kitekid250/The-Vulture/Mechanical/Other/WingPotMount_Rendering.JPG

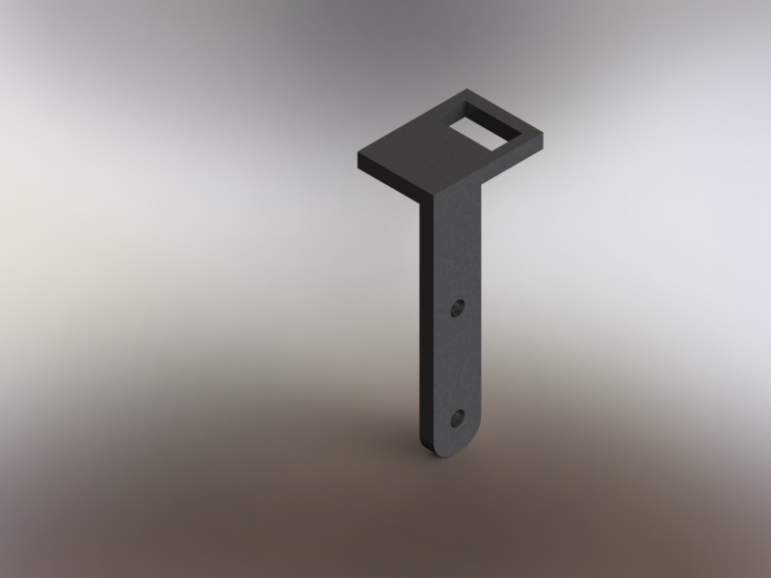
Mechanical/Other/WingPotMount_Rendering.JPG
