kitekid250/The-Vulture/README.md

# The-Vulture
Work done on the robotic Vulture for Dana 147
