kitekid250/The-Vulture/Mechanical/03.gif

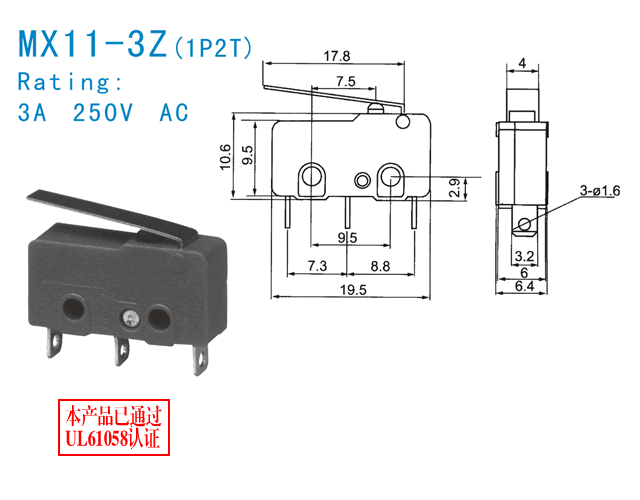
Mechanical/03.gif
