kitekid250/The-Vulture/Mechanical/Tensioner Sub Assembly/TensionerAssembly.SLDASM

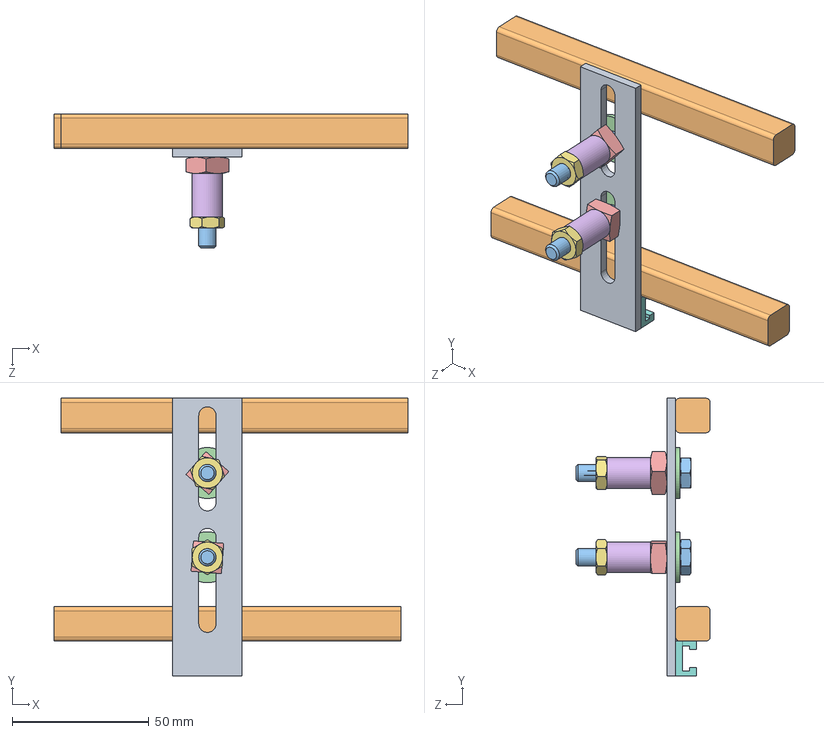
[picture p3: CAD file, 2015-04-28]
Mechanical/Tensioner Sub Assembly/TensionerAssembly.SLDASM
129.5 x 101.6 x 49.2 mm
Back plate
Bar x 2
hex finished bolt_ai x 2
flat washer type b regular_ai x 2
square nut_61_ai x 2
Roller x 2
hex jam nut_ai x 2
Sensor Mount
