kitekid250/The-Vulture/Mechanical/Other/ArmsPotentiometerSupport_Revised.STL

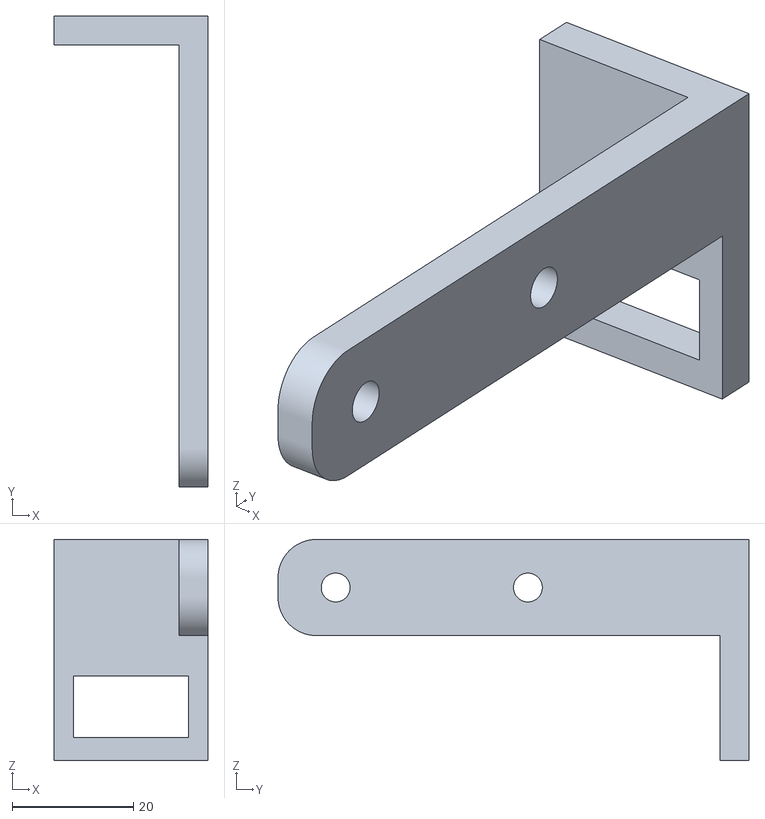
[picture p4: CAD file, 2015-04-28]
Mechanical/Other/ArmsPotentiometerSupport_Revised.STL
25.4 x 77.8 x 36.5
