kitekid250/The-Vulture/Mechanical/Parts/Front Panel.SLDPRT

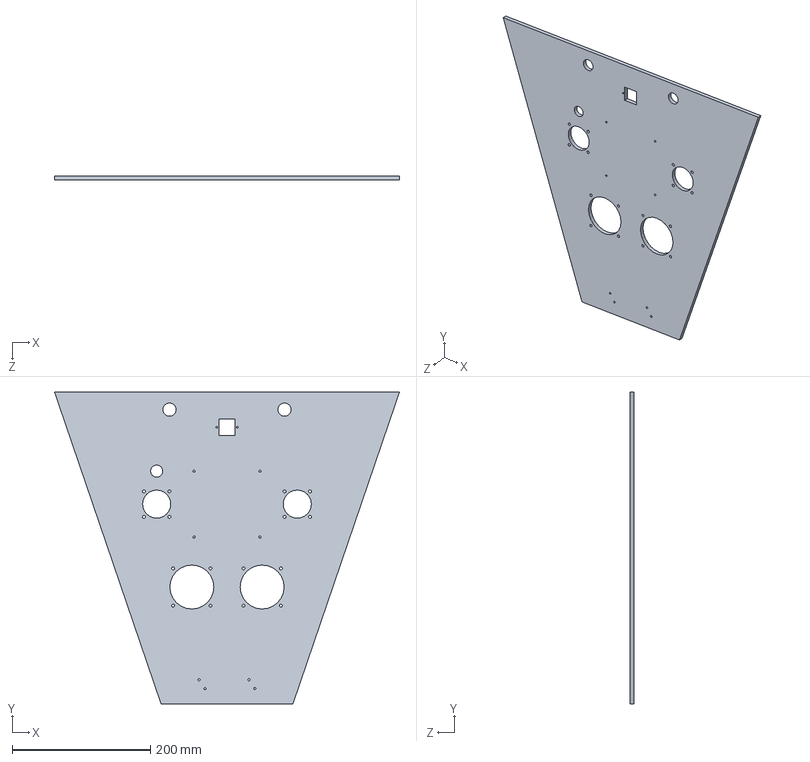
[picture p5: CAD file, 2015-05-24]
Mechanical/Parts/Front Panel.SLDPRT
498.5 x 450.7 x 6.35 mm
