kitekid250/The-Vulture/Mechanical/Tensioner Sub Assembly/Sensor Mount.SLDPRT

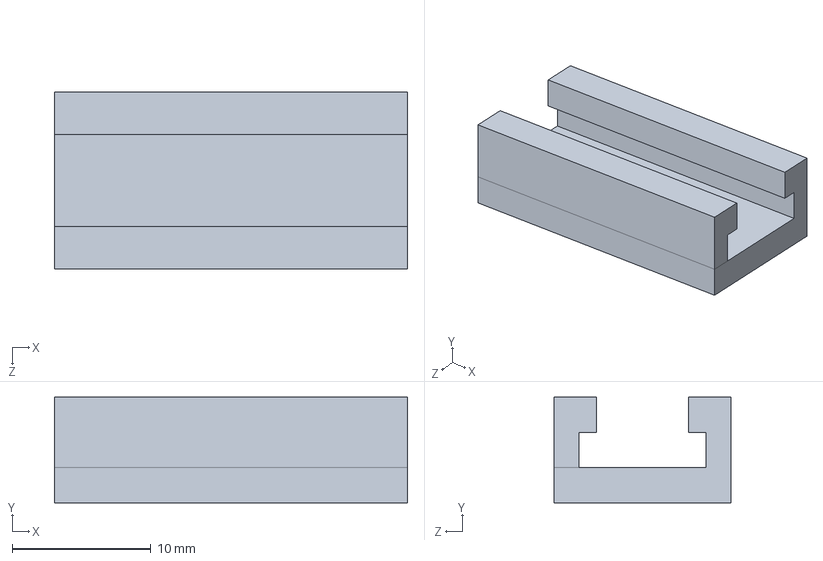
[picture p6: CAD file, 2015-04-28]
Mechanical/Tensioner Sub Assembly/Sensor Mount.SLDPRT
25.4 x 7.62 x 12.7 mm
