kitekid250/The-Vulture/Mechanical/Other/Electronics Plate.DXF

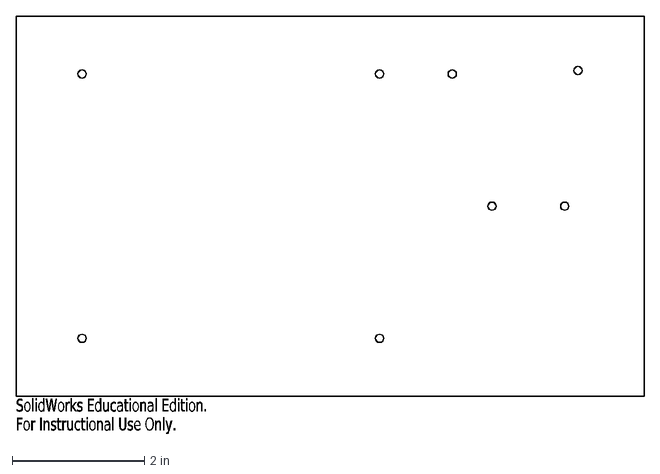
[picture p7: CAD file, 2015-04-28]
Mechanical/Other/Electronics Plate.DXF
SolidWorks Educational Edition.
For Instructional Use Only.
