kitekid250/The-Vulture/Mechanical/Parts/Triangle.SLDPRT

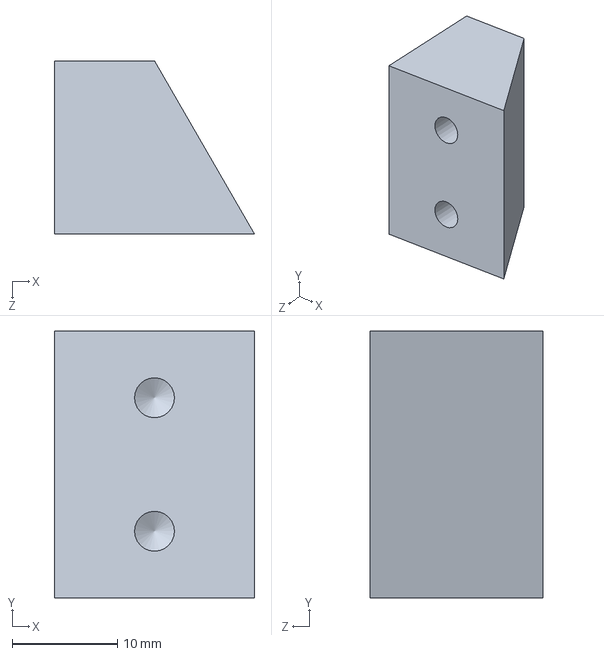
[picture p8: CAD file, 2015-05-15]
Mechanical/Parts/Triangle.SLDPRT
19.1 x 25.4 x 16.5 mm
