kitekid250/The-Vulture/Mechanical/Tensioner Sub Assembly/Bar.SLDPRT

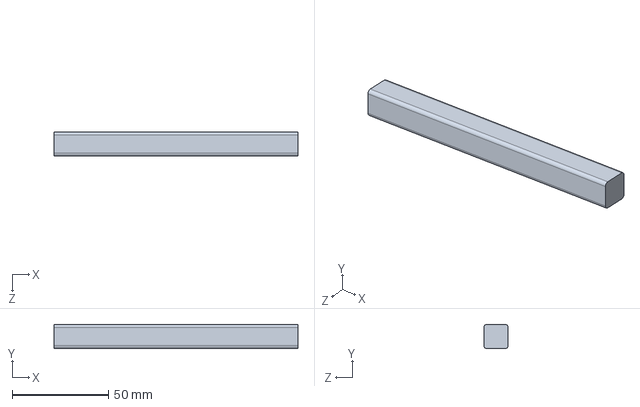
[picture p9: CAD file, 2015-04-28]
Mechanical/Tensioner Sub Assembly/Bar.SLDPRT
127.0 x 12.7 x 12.7 mm
