kitekid250/The-Vulture/Mechanical/Parts/Wing Top Limit Switch Mount.SLDPRT

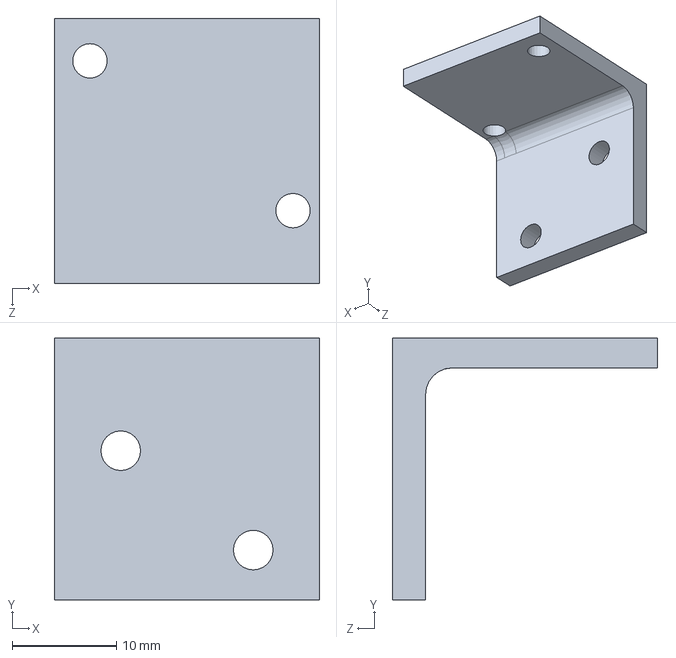
[picture p10: CAD file, 2015-05-15]
Mechanical/Parts/Wing Top Limit Switch Mount.SLDPRT
25.4 x 25.1 x 25.4 mm
