kitekid250/The-Vulture/Mechanical/Parts/LPOTPT.SLDPRT

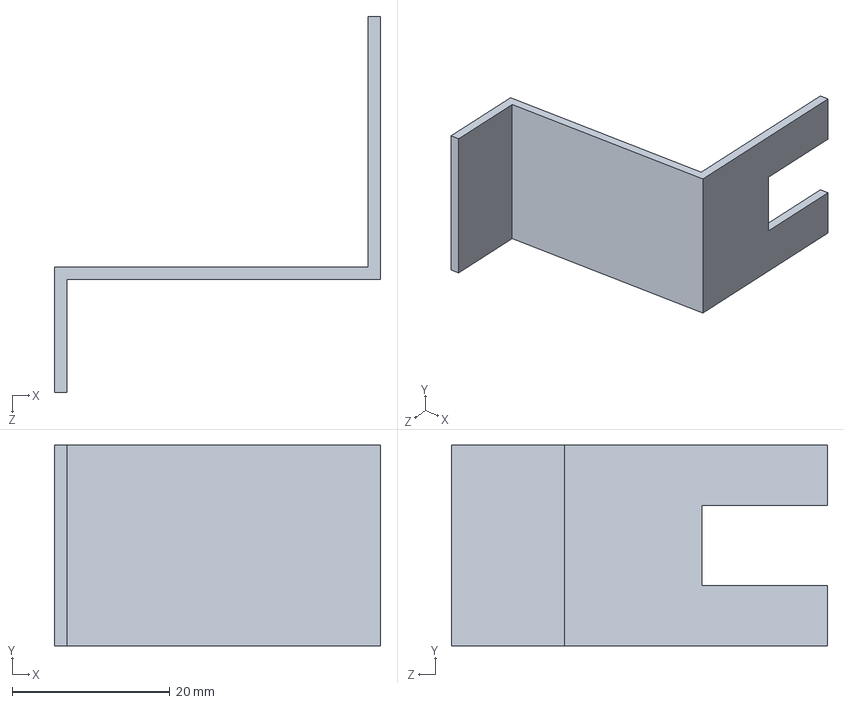
[picture p11: CAD file, 2015-04-28]
Mechanical/Parts/LPOTPT.SLDPRT
41.3 x 25.4 x 47.6 mm
