kitekid250/The-Vulture/Mechanical/Tensioner Sub Assembly/Roller.SLDPRT

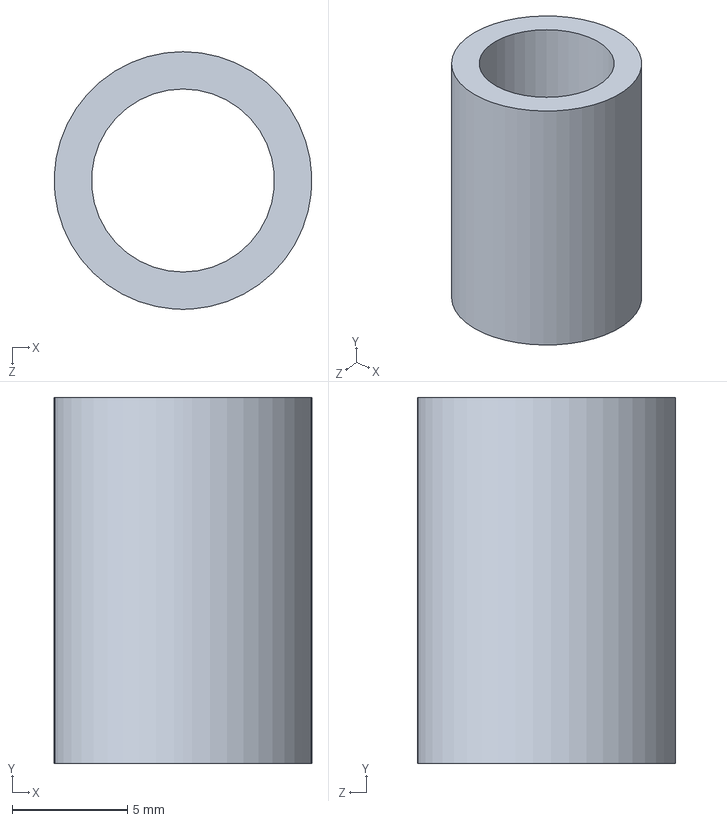
[picture p12: CAD file, 2015-04-28]
Mechanical/Tensioner Sub Assembly/Roller.SLDPRT
11.2 x 15.9 x 11.2 mm
