kitekid250/The-Vulture/Mechanical/Tensioner Sub Assembly/Back plate.SLDPRT

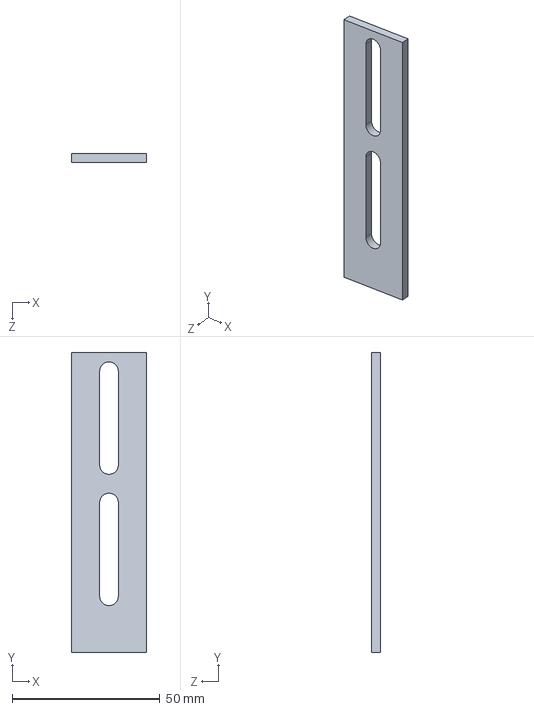
[picture p13: CAD file, 2015-04-28]
Mechanical/Tensioner Sub Assembly/Back plate.SLDPRT
25.4 x 101.6 x 3.17 mm
