kitekid250/The-Vulture/Mechanical/Parts/RPOTPT.SLDPRT

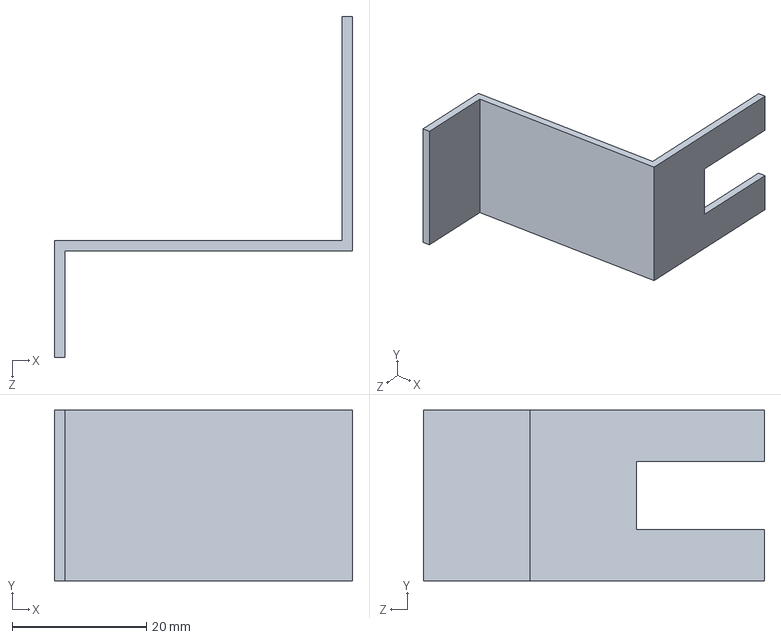
[picture p14: CAD file, 2015-04-28]
Mechanical/Parts/RPOTPT.SLDPRT
44.5 x 25.4 x 50.8 mm
