kitekid250/The-Vulture/Mechanical/Parts/NeckLimitswitchMountBottom.SLDPRT

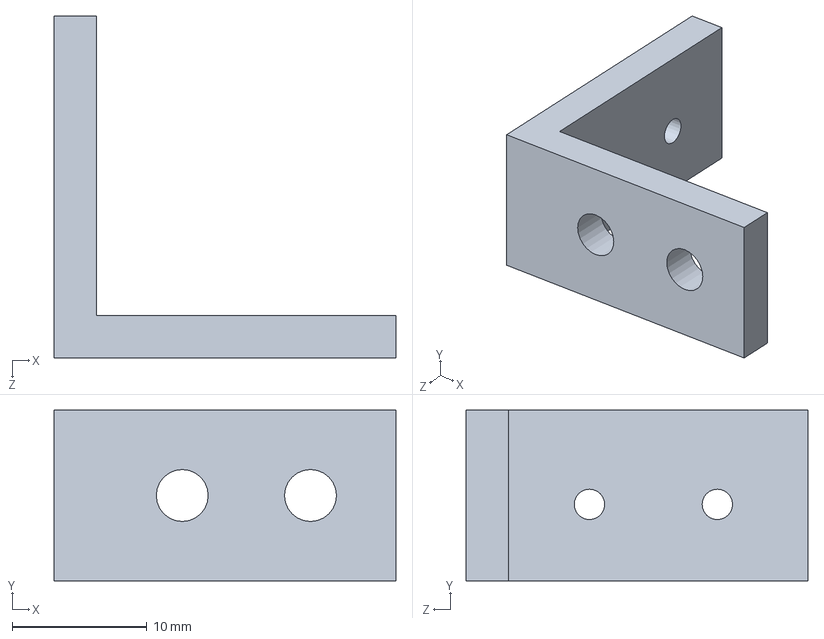
[picture p15: CAD file, 2015-04-28]
Mechanical/Parts/NeckLimitswitchMountBottom.SLDPRT
25.4 x 12.7 x 25.4 mm
