kitekid250/The-Vulture/Mechanical/Parts/Shoulder Top Limit Switch Mount V2.SLDPRT

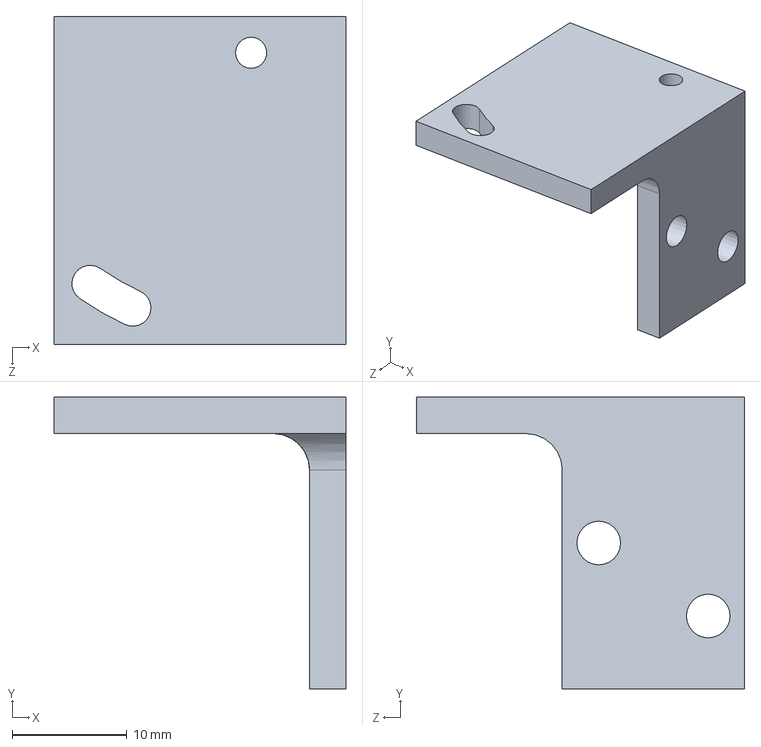
[picture p16: CAD file, 2015-04-28]
Mechanical/Parts/Shoulder Top Limit Switch Mount V2.SLDPRT
25.4 x 25.4 x 28.6 mm
