kitekid250/The-Vulture/Mechanical/Parts/Wing Pot Support V2.SLDPRT

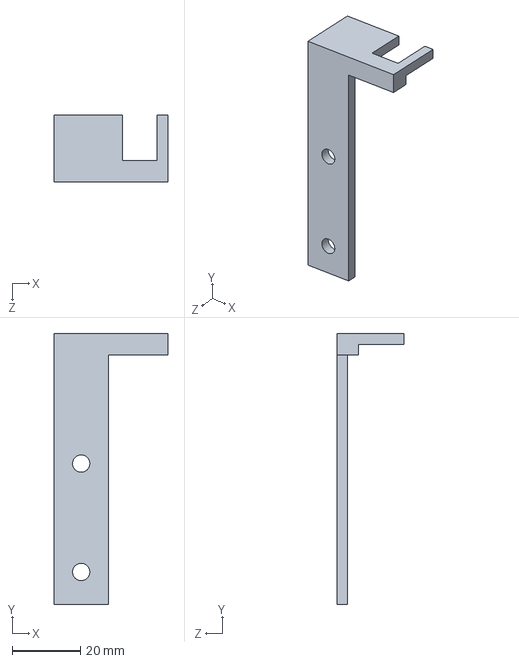
[picture p17: CAD file, 2015-04-28]
Mechanical/Parts/Wing Pot Support V2.SLDPRT
33.3 x 79.4 x 19.7 mm
