kitekid250/The-Vulture/Mechanical/Parts/NeckLimitswitchMountTop.SLDPRT

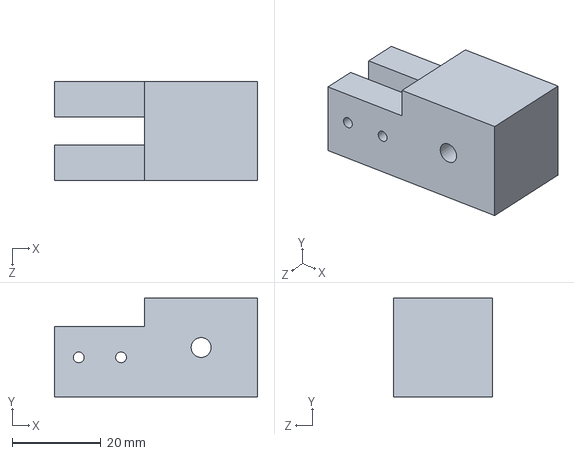
[picture p18: CAD file, 2015-04-28]
Mechanical/Parts/NeckLimitswitchMountTop.SLDPRT
45.7 x 22.2 x 22.2 mm
