kitekid250/The-Vulture/Mechanical/Parts/WingPotentiometerSupport_Revised.SLDPRT

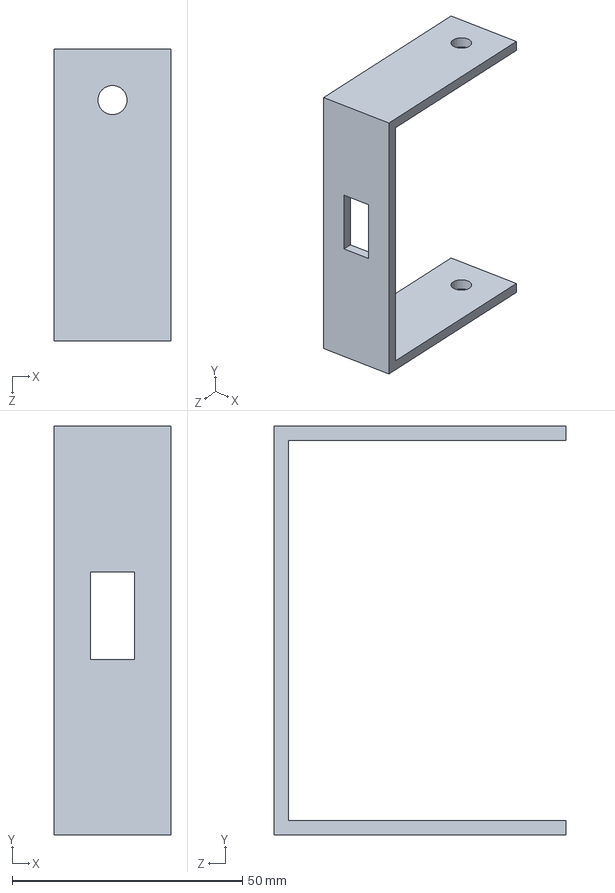
[picture p19: CAD file, 2015-04-28]
Mechanical/Parts/WingPotentiometerSupport_Revised.SLDPRT
25.4 x 88.9 x 63.5 mm
