kitekid250/The-Vulture/Mechanical/Parts/Speaker Offset.SLDPRT

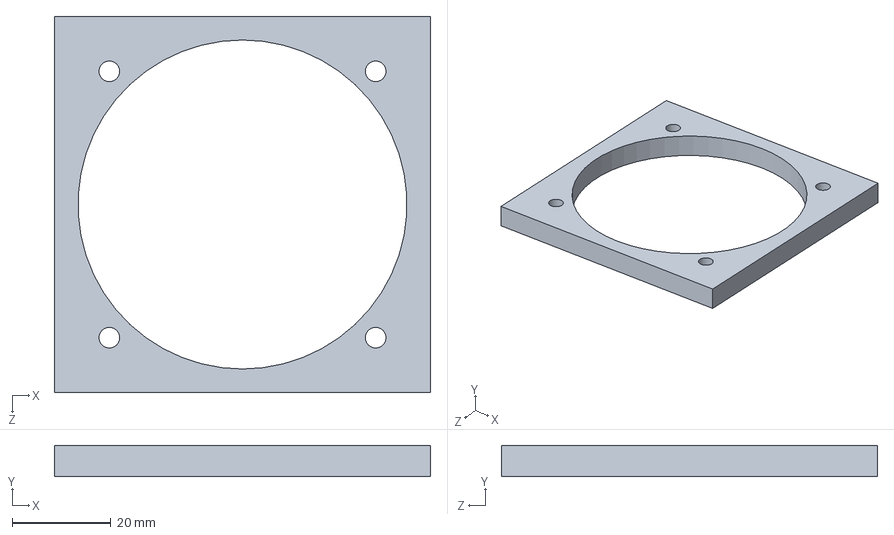
[picture p20: CAD file, 2015-04-28]
Mechanical/Parts/Speaker Offset.SLDPRT
76.2 x 6.35 x 76.2 mm
