kitekid250/The-Vulture/Mechanical/Parts/Fix.SLDPRT

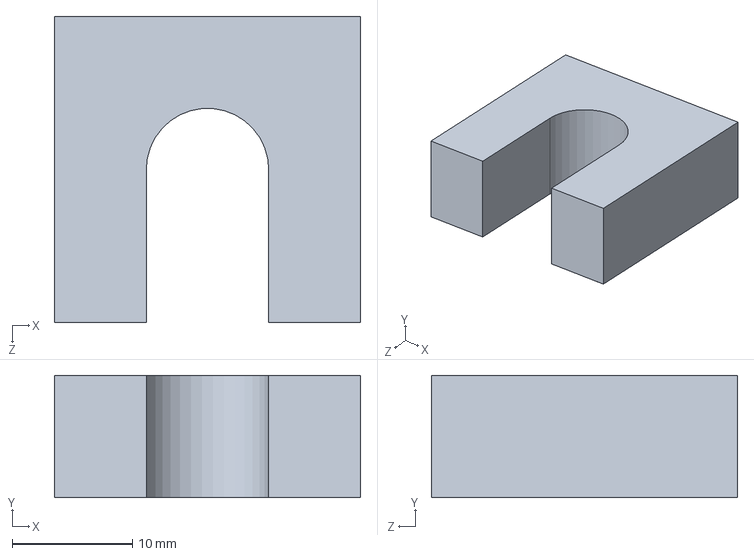
[picture p21: CAD file, 2015-04-28]
Mechanical/Parts/Fix.SLDPRT
25.4 x 10.2 x 25.4 mm
