kitekid250/The-Vulture/Mechanical/Parts/Neck Carriage.SLDPRT

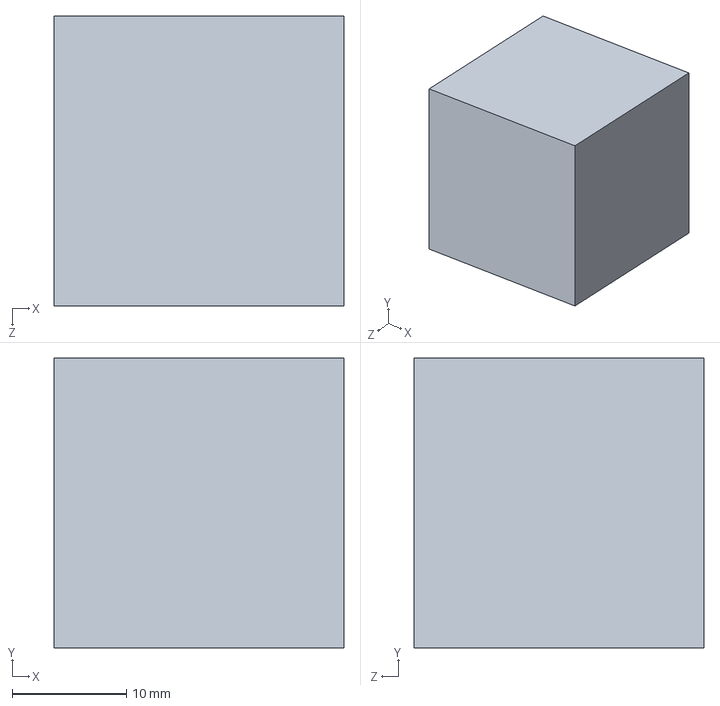
[picture p22: CAD file, 2015-04-28]
Mechanical/Parts/Neck Carriage.SLDPRT
25.4 x 25.4 x 25.4 mm
