kitekid250/The-Vulture/Mechanical/Parts/PlexiBottomHook V1.SLDPRT

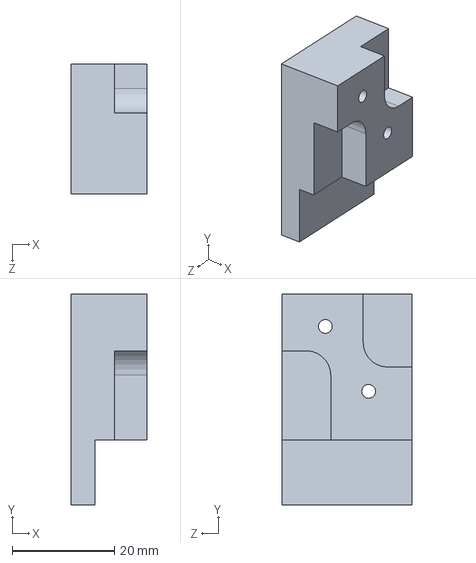
[picture p23: CAD file, 2015-04-28]
Mechanical/Parts/PlexiBottomHook V1.SLDPRT
14.9 x 41.3 x 25.4 mm
