kitekid250/The-Vulture/Mechanical/Parts/Wing Pot Holder V2.SLDPRT

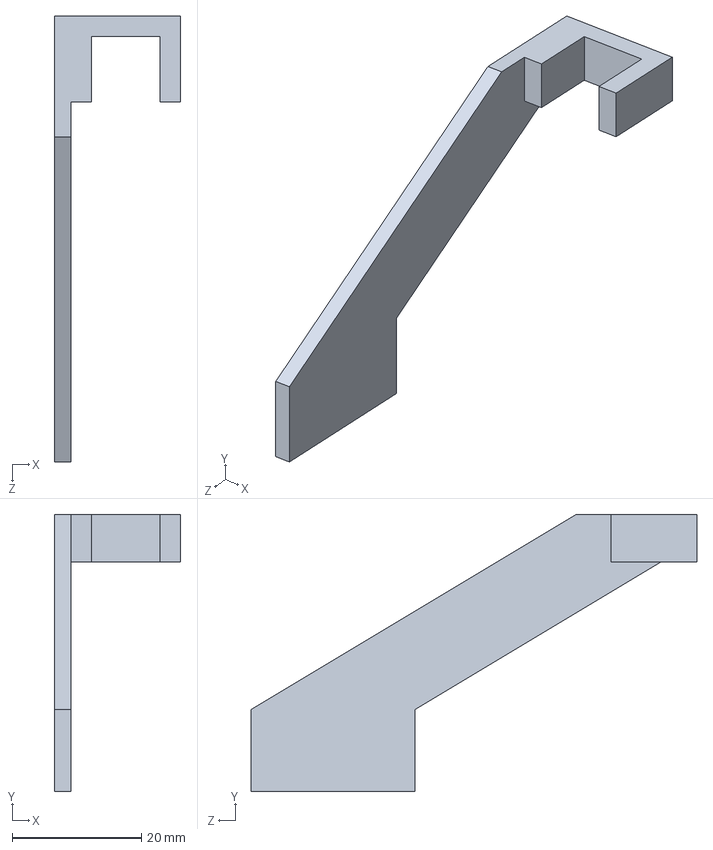
[picture p24: CAD file, 2015-04-28]
Mechanical/Parts/Wing Pot Holder V2.SLDPRT
19.6 x 42.9 x 69.1 mm
