kitekid250/The-Vulture/Mechanical/Parts/Electronics Plate.SLDPRT

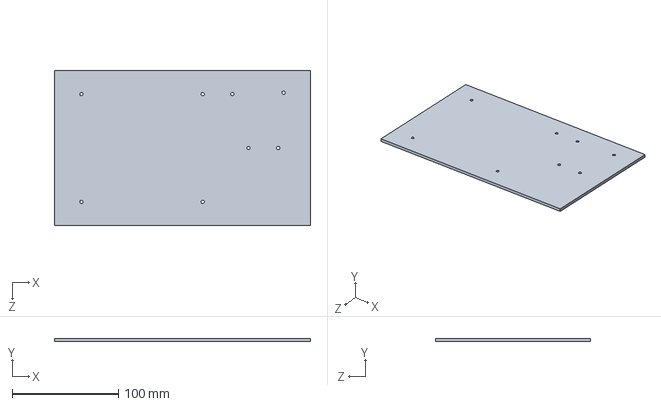
[picture p25: CAD file, 2015-04-28]
Mechanical/Parts/Electronics Plate.SLDPRT
241.3 x 3.17 x 146.1 mm
