kitekid250/The-Vulture/Mechanical/Parts/Wing LS Outside Actuator.SLDPRT

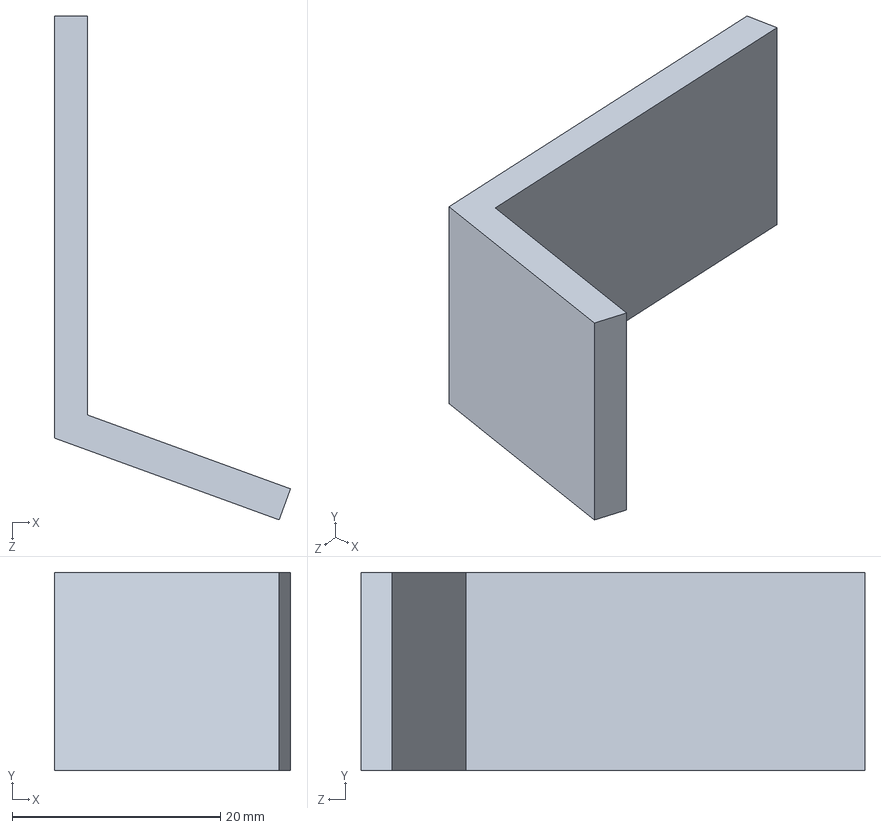
[picture p26: CAD file, 2015-04-28]
Mechanical/Parts/Wing LS Outside Actuator.SLDPRT
22.7 x 19.1 x 48.4 mm
