kitekid250/The-Vulture/Mechanical/Parts/Wing LS Inside.SLDPRT

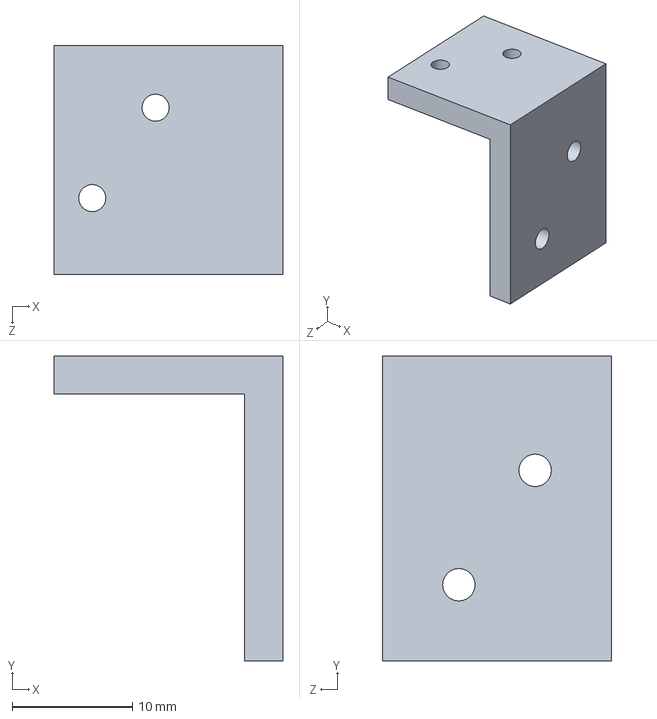
[picture p27: CAD file, 2015-04-28]
Mechanical/Parts/Wing LS Inside.SLDPRT
19.1 x 25.4 x 19.0 mm
