kitekid250/The-Vulture/(list of files, cad)

Other CAD files:
Mechanical/Parts/ArmsPotentiometerSupport_Revised.SLDPRT
Mechanical/Parts/TPOTPT.SLDPRT
Mechanical/Drawings/Front Panel.SLDDRW
Mechanical/Drawings/LPOTPT.SLDDRW
Mechanical/Drawings/NeckLimitswitchMountBottom.SLDDRW
Mechanical/Drawings/NeckTopLimitSwitchMount.SLDDRW
Mechanical/Drawings/PlexiBottomHook V1.SLDDRW
Mechanical/Drawings/PlexiBottomHook V2.SLDDRW
Mechanical/Drawings/RPOTPT.SLDDRW
Mechanical/Drawings/TPOTPT.SLDDRW
Mechanical/Drawings/Vulture Parts to Fab.SLDDRW
Mechanical/Drawings/Wing LS Inside.SLDDRW
Mechanical/Drawings/WingTipLimitSwitchMount.SLDDRW
Mechanical/Parts/Shoulder Top Limit Switch Mount V2.SLDDRW
Mechanical/Tensioner Sub Assembly/TensionerParts.SLDDRW
