kitekid250/The-Vulture/Mechanical/Tensioner Sub Assembly/TensionerPartsFinal.PDF

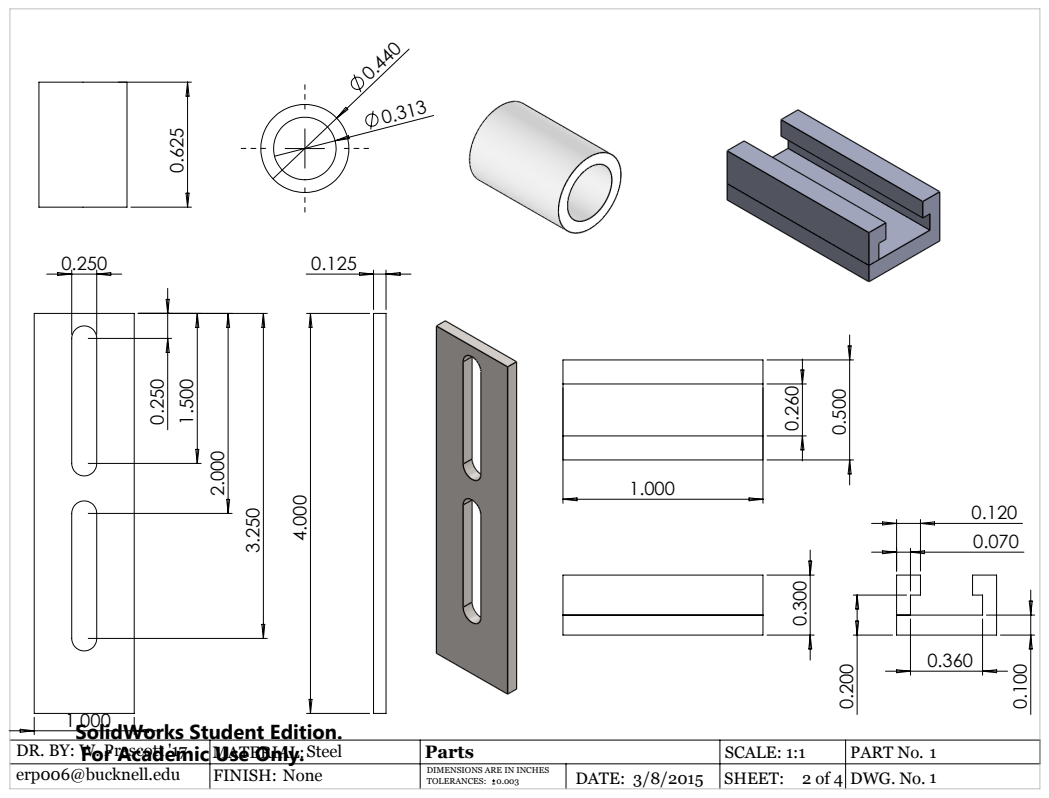
[picture p29: page 1]

SolidWorks Student Edition.

For Academic Use Only. DR. BY: W. Prescott '17 | MATERIAL: Steel | Parts | SCALE: 1:1 | 1 PART No.
erp006@bucknell.edu | FINISH: None | TOLERANCES: 0.003 | 3/8/2015 DATE: | 2 of 4 DIMENSIONS ARE IN INCHES SHEET: | 1 DWG. No.
