kitekid250/The-Vulture/Mechanical/Drawings/Front Panel.PDF

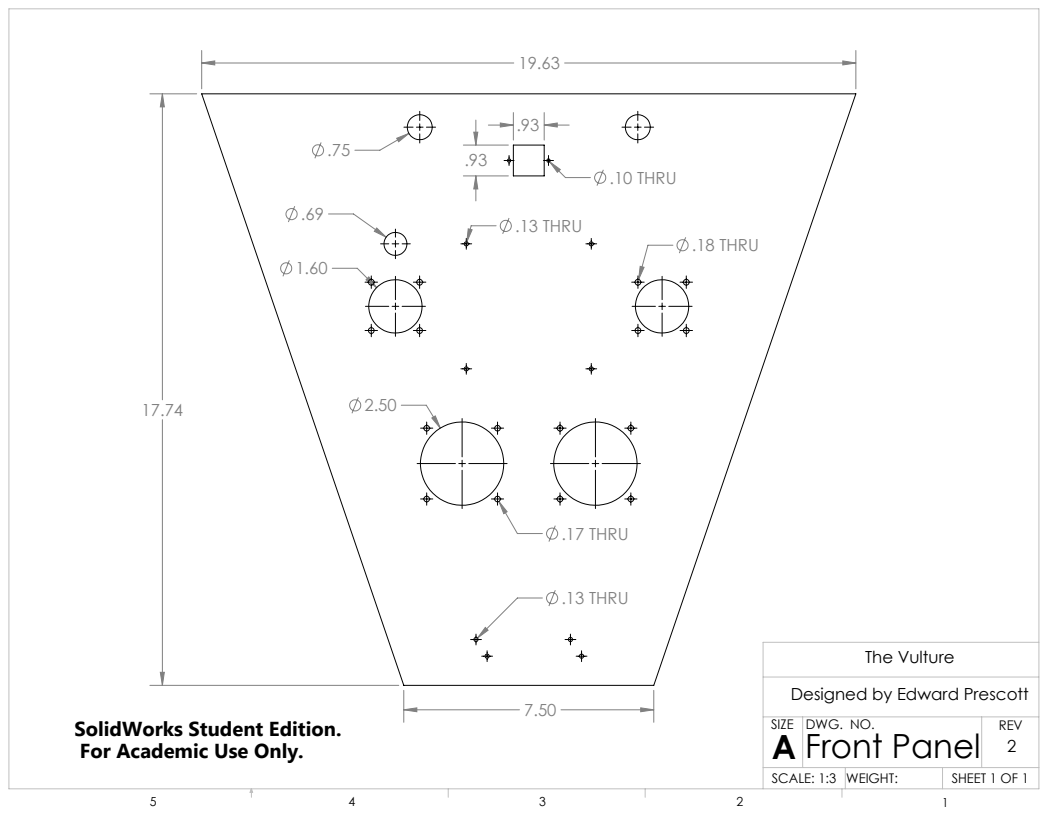
[picture p30: page 1]
.13 THRU; .18 THRU; .10 THRU; .17 THRU; The Vulture; Front Panel 2; SCALE: 1:3 WEIGHT:; SHEET 1 OF 1; DWG. NO.; REV

Designed by Edward Prescott
SIZE

SolidWorks Student Edition.
For Academic Use Only.
