kitekid250/The-Vulture/Circuit/Vulture Controls - Copy.brd

## EAGLE design Circuit/Vulture Controls - Copy.brd (2015-09-29, an earlier design)

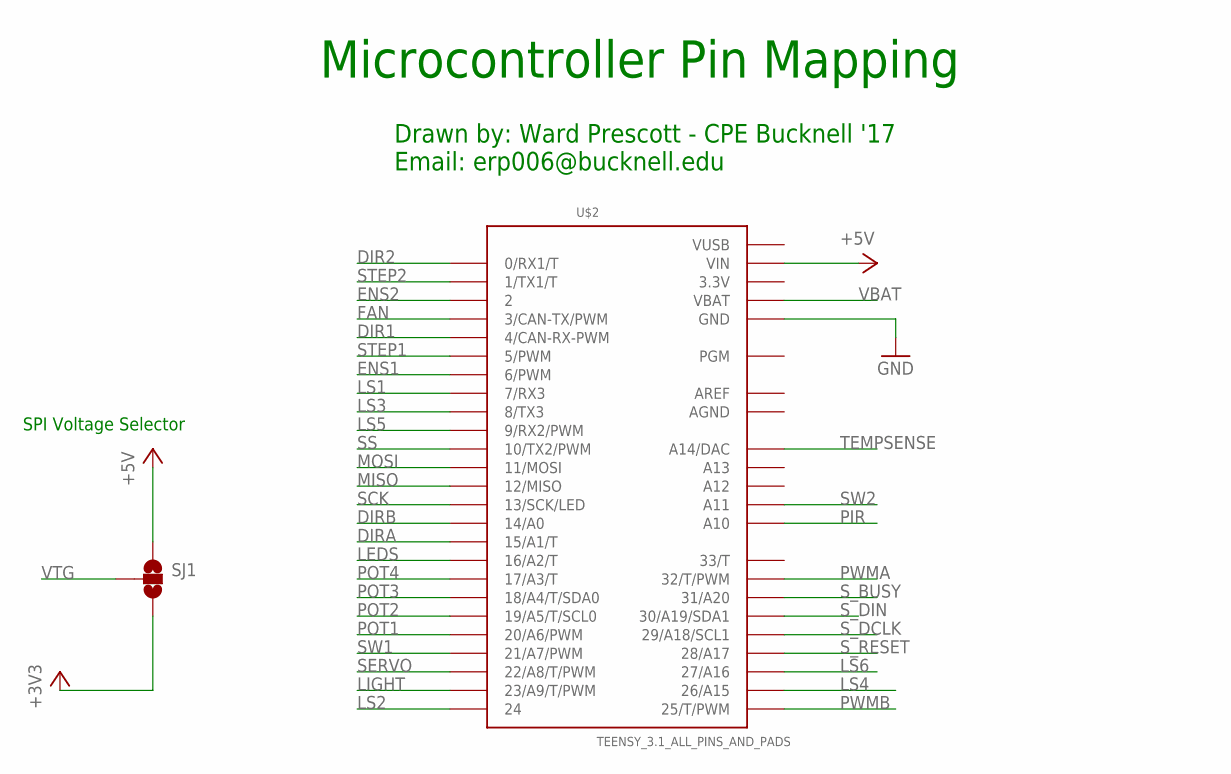
[picture p31: schematic Vulture Controls - Copy.sch, sheet 1, IC - Teensy 3.1]

Parts:
SJ1: JUMPER-PAD-3-NOFULL_BOX_SILK; PAD-JUMPER-3-NO_YES_SILK_FULL_BOX
U$2: TEENSY_3.1_ALL_PINS_AND_PADS; TEENSY_3.1_ALLPINS

Connections:
3.3V: U$2.3.3V, U$2.3.3V1 (3.3V), U$2.3.3V2 (3.3V)
+3V3: SJ1.3; also elsewhere on the board
+5V: SJ1.1, U$2.VIN; also elsewhere on the board
AGND: U$2.AGND
AREF: U$2.AREF
DIR1: U$2.4 (4/CAN-RX-PWM); also elsewhere on the board
DIR2: U$2.0 (0/RX1/T); also elsewhere on the board
DIRA: U$2.15/A1 (15/A1/T); also elsewhere on the board
DIRB: U$2.14/A0; also elsewhere on the board
ENS1: U$2.6 (6/PWM); also elsewhere on the board
ENS2: U$2.2; also elsewhere on the board
FAN: U$2.3 (3/CAN-TX/PWM); also elsewhere on the board
GND: U$2.GND, U$2.GND1 (GND), U$2.GND2 (GND); also elsewhere on the board
LEDS: U$2.16/A2 (16/A2/T); also elsewhere on the board
LIGHT: U$2.23/A9 (23/A9/T/PWM); also elsewhere on the board
LS1: U$2.7 (7/RX3); also elsewhere on the board
LS2: U$2.24; also elsewhere on the board
LS3: U$2.8 (8/TX3); also elsewhere on the board
LS4: U$2.26 (26/A15); also elsewhere on the board
LS5: U$2.9 (9/RX2/PWM); also elsewhere on the board
LS6: U$2.27 (27/A16); also elsewhere on the board
MISO: U$2.12 (12/MISO); also elsewhere on the board
MOSI: U$2.11 (11/MOSI); also elsewhere on the board
PIR: U$2.A10; also elsewhere on the board
POT1: U$2.20/A6 (20/A6/PWM); also elsewhere on the board
POT2: U$2.19/A5 (19/A5/T/SCL0); also elsewhere on the board
POT3: U$2.18/A4 (18/A4/T/SDA0); also elsewhere on the board
POT4: U$2.17/A3 (17/A3/T); also elsewhere on the board
PWMA: U$2.32 (32/T/PWM); also elsewhere on the board
PWMB: U$2.25 (25/T/PWM); also elsewhere on the board
SCK: U$2.13 (13/SCK/LED); also elsewhere on the board
SERVO: U$2.22/A8 (22/A8/T/PWM); also elsewhere on the board
SS: U$2.10 (10/TX2/PWM); also elsewhere on the board
STEP1: U$2.5 (5/PWM); also elsewhere on the board
STEP2: U$2.1 (1/TX1/T); also elsewhere on the board
SW1: U$2.21/A7 (21/A7/PWM); also elsewhere on the board
SW2: U$2.A11; also elsewhere on the board
S_BUSY: U$2.31 (31/A20); also elsewhere on the board
S_DCLK: U$2.29 (29/A18/SCL1); also elsewhere on the board
S_DIN: U$2.30 (30/A19/SDA1); also elsewhere on the board
S_RESET: U$2.28 (28/A17); also elsewhere on the board
TEMPSENSE: U$2.A14 (A14/DAC); also elsewhere on the board
VBAT: U$2.VBAT; also elsewhere on the board
VTG: SJ1.2; also elsewhere on the board
VUSB: U$2.VUSB

Notes on the sheet:
Microcontroller Pin Mapping
Drawn by: Ward Prescott - CPE Bucknell '17 Email: erp006@bucknell.edu
SPI Voltage Selector

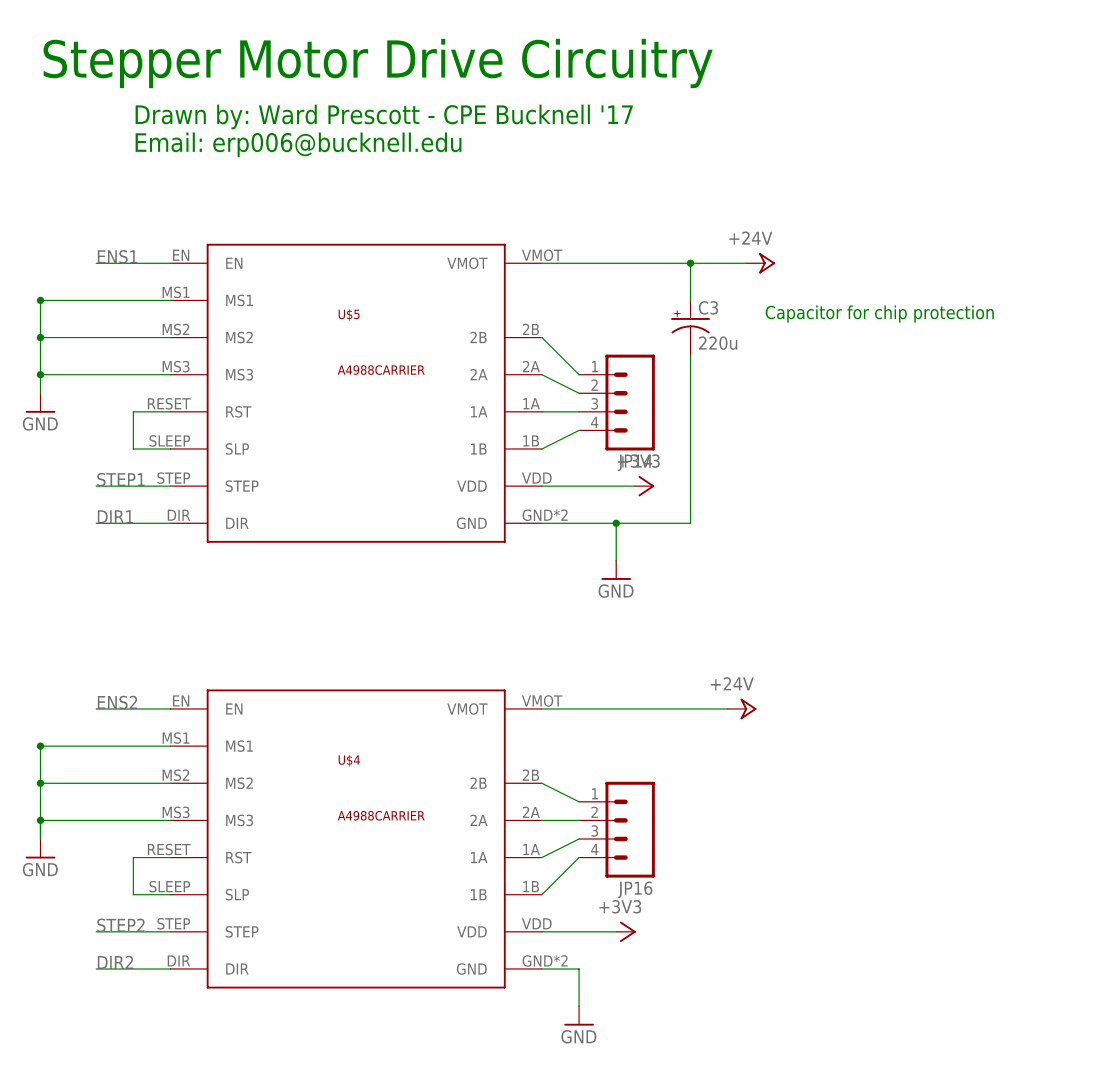
[picture p32: schematic Vulture Controls - Copy.sch, sheet 2, Stepper Motor Drive]

Parts:
C3: 220u; CPOL-RADIAL-1000UF-25V
JP14, JP16: M04POLAR_LOCK; MOLEX-1X4_LOCK
U$4, U$5: A4988CARRIER

Connections:
+3V3: U$4.VDD, U$5.VDD; also elsewhere on the board
+24V: C3.+, U$4.VMOT, U$5.VMOT; also elsewhere on the board
DIR1: U$5.DIR; also elsewhere on the board
DIR2: U$4.DIR; also elsewhere on the board
ENS1: U$5.EN; also elsewhere on the board
ENS2: U$4.EN; also elsewhere on the board
GND: C3.-, U$4.GND, U$4.GND2 (GND), U$4.MS1, U$4.MS2, U$4.MS3, U$5.GND, U$5.GND2 (GND), U$5.MS1, U$5.MS2, U$5.MS3; also elsewhere on the board
unnamed: JP14.1, U$5.2B
unnamed: JP14.2, U$5.2A
unnamed: JP14.3, U$5.1A
unnamed: JP14.4, U$5.1B
unnamed: JP16.1, U$4.2B
unnamed: JP16.2, U$4.2A
unnamed: JP16.3, U$4.1A
unnamed: JP16.4, U$4.1B
unnamed: U$5.RESET (RST), U$5.SLEEP (SLP)
unnamed: U$4.RESET (RST), U$4.SLEEP (SLP)
STEP1: U$5.STEP; also elsewhere on the board
STEP2: U$4.STEP; also elsewhere on the board

Notes on the sheet:
Capacitor for chip protection
Stepper Motor Drive Circuitry
Drawn by: Ward Prescott - CPE Bucknell '17 Email: erp006@bucknell.edu

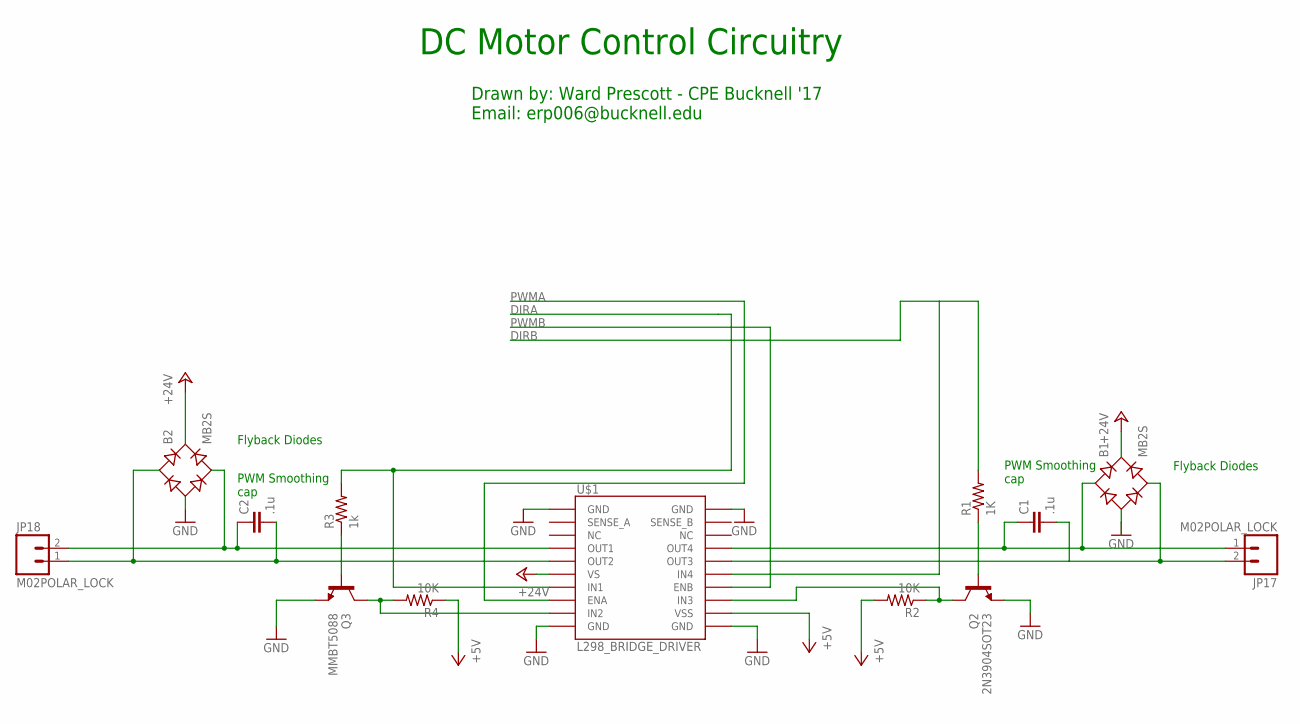
[picture p33: schematic Vulture Controls - Copy.sch, sheet 3, DC Motor Control]

Parts:
B1, B2: MB2S; SOIC-4
C1, C2: .1u; 1210
JP17, JP18: M02POLAR_LOCK; MOLEX-1X2_LOCK
Q2: 2N3904SOT23; SOT23
Q3: MMBT5088; SOT23
R1: 1K; 0805
R2, R4: 10K; 0603-RES
R3: 1k; 0805
U$1: L298_BRIDGE_DRIVER; POWERSO20

Connections:
+5V: R2.2, R4.1, U$1.12 (VSS); also elsewhere on the board
+24V: B1.+, B2.+, U$1.6 (VS); also elsewhere on the board
DIRA: R3.2, U$1.7 (IN1); also elsewhere on the board
DIRB: R1.2, U$1.15 (IN4); also elsewhere on the board
GND: B1.-, B2.-, Q2.2 (E), Q3.2 (E), U$1.1 (GND), U$1.10 (GND), U$1.11 (GND), U$1.20 (GND), U$1.P$1 (GND); also elsewhere on the board
unnamed: B2.~2 (AC2), C2.1, JP18.2, U$1.4 (OUT1)
unnamed: B2.~1 (AC1), C2.2, JP18.1, U$1.5 (OUT2)
unnamed: B1.~1 (AC1), C1.1, JP17.1, U$1.17 (OUT4)
unnamed: B1.~2 (AC2), C1.2, JP17.2, U$1.16 (OUT3)
unnamed: Q2.1 (B), R1.1
unnamed: Q2.3 (C), R2.1, U$1.13 (IN3)
unnamed: Q3.1 (B), R3.1
unnamed: Q3.3 (C), R4.2, U$1.9 (IN2)
PWMA: U$1.8 (ENA); also elsewhere on the board
PWMB: U$1.14 (ENB); also elsewhere on the board

Notes on the sheet:
Flyback Diodes
PWM Smoothing cap
DC Motor Control Circuitry
Drawn by: Ward Prescott - CPE Bucknell '17 Email: erp006@bucknell.edu

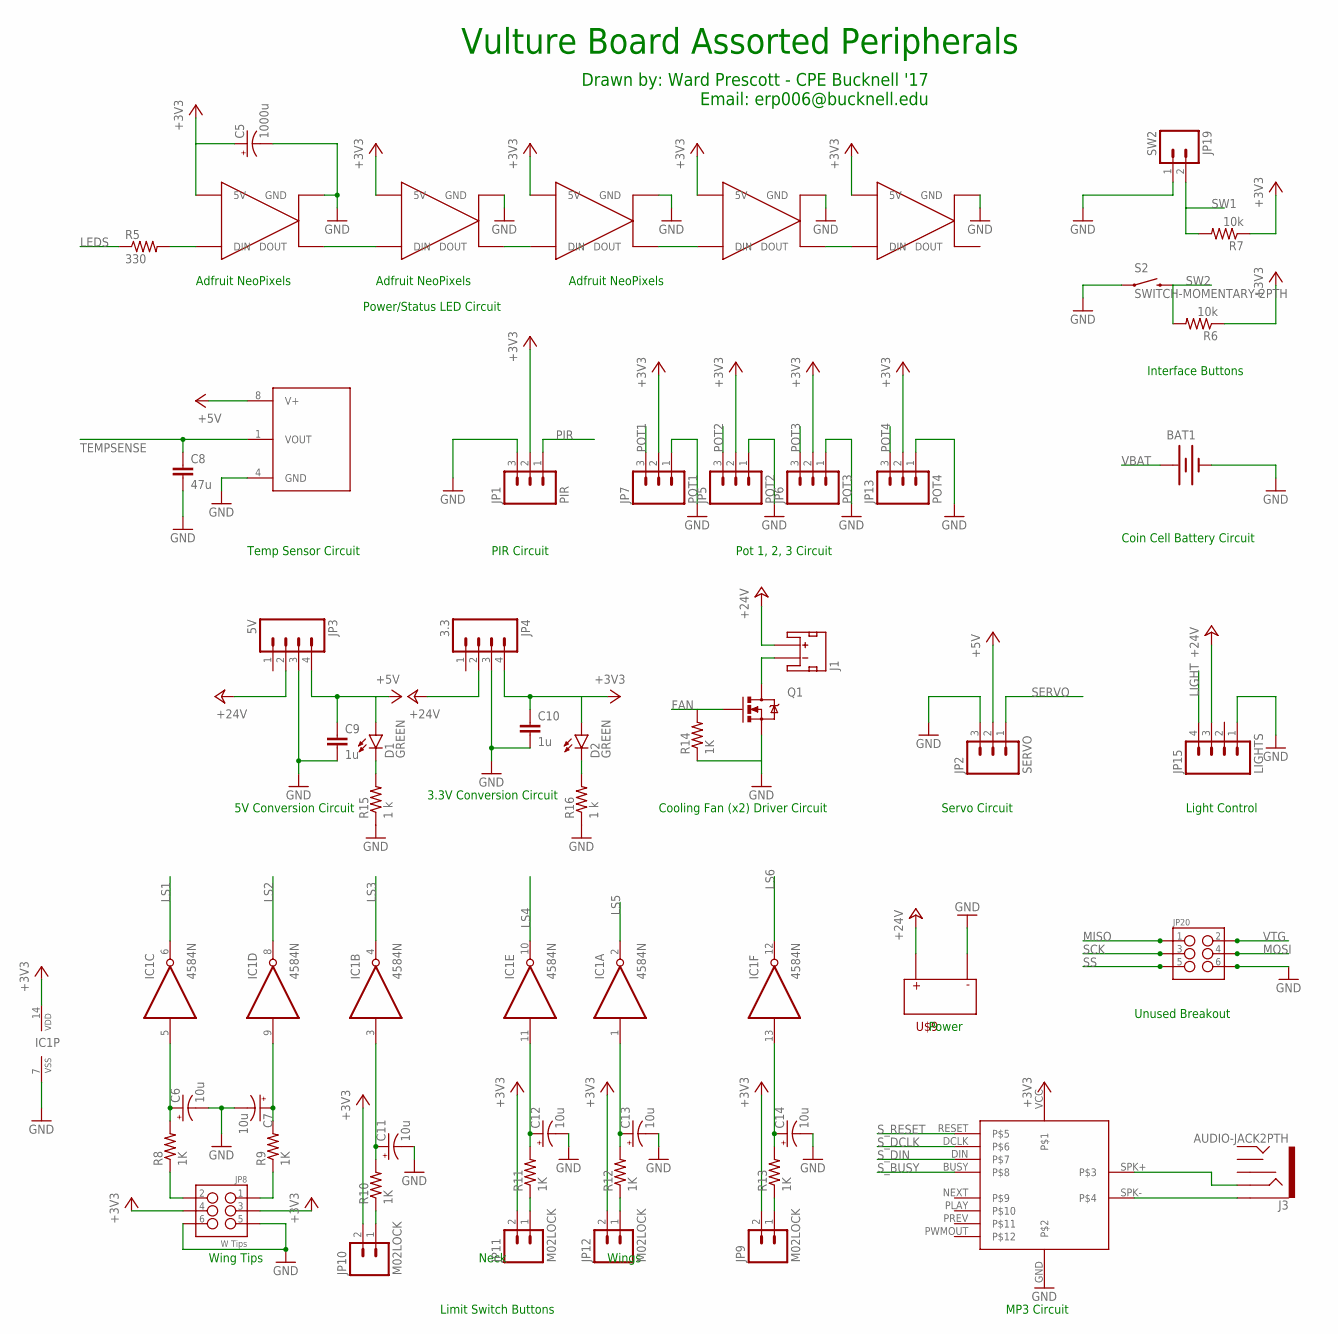
[picture p34: schematic Vulture Controls - Copy.sch, sheet 4, Other Peripherals]

Parts:
BAT1: BATTERY20PTH; BATTCOM_20MM_PTH
C5: 1000u; PANASONIC_G
C6, C7, C11, C12, C13, C14: 10u; PANASONIC_C
C8: 47u; 1206
C9, C10: 1u; 1206
D1, D2: GREEN; LED-1206
IC1: 4584N; DIL14
J1: JST_2MM_MALE; JST-2-SMD
J3: AUDIO-JACK2PTH; AUDIO-JACK
JP1: PIR; 1X03_LOCK_LONGPADS
JP2: SERVO; 1X03_LOCK_LONGPADS
JP3: 5V; 1X04_LOCK
JP4: 3.3; 1X04_LOCK
JP5: POT2; 1X03_LOCK_LONGPADS
JP6: POT3; 1X03_LOCK_LONGPADS
JP7: POT1; 1X03_LOCK_LONGPADS
JP8: W Tips; 2X3_POGO
JP9, JP10, JP11, JP12: M02LOCK; 1X02_LOCK
JP13: POT4; 1X03_LOCK_LONGPADS
JP15: LIGHTS; MOLEX-1X4_LOCK
JP19: SW2; 1X02_LOCK
JP20: M03X2POGO_PINS; 2X3_POGO
Q1: SSM3K329R,LF; SOT323
R5: 330; 0603-RES
R6, R7: 10k; 0603-RES
R8, R9, R10, R11, R12, R13, R14: 1K; 0805
R15, R16: 1 k; 0805
S2: SWITCH-MOMENTARY-2PTH; TACTILE-PTH
U$3: LM34; SO08
U$6, U$7, U$8, U$10, U$11: NEOPIXEL_THT
U$9: CONN_HDR_2POS_7.5MM_R/A_SLDR; MOLEXPOWER
U$12: WTV020SD-BRKOUT; WTVO20SD-BRKKOUT

Connections:
+3V3: C5.+, C10.1, D2.A, IC1.14 (VDD), JP1.2, JP4.4, JP5.2, JP6.2, JP7.2, JP8.P$3 (3), JP8.P$4 (4), JP9.2, JP10.2, JP11.2, JP12.2, JP13.2, R6.1, R7.1, U$6.5V, U$7.5V, U$8.5V, U$10.5V, U$11.5V, U$12.VCC; also elsewhere on the board
+5V: C9.1, D1.A, JP2.2, JP3.4, U$3.8 (V+); also elsewhere on the board
+24V: J1.2 (+), JP3.2, JP4.2, JP15.3, U$9.P$1, U$9.P$2; also elsewhere on the board
FAN: Q1.1 (G), R14.2; also elsewhere on the board
GND: BAT1.2 (-), C5.-, C6.-, C7.-, C8.2, C9.2, C10.2, C11.-, C12.-, C13.-, C14.-, IC1.7 (VSS), JP1.3, JP2.3, JP3.3, JP4.3, JP5.1, JP6.1, JP7.1, JP8.P$5 (5), JP8.P$6 (6), JP13.1, JP15.1, JP19.1, JP20.P$6 (6), Q1.2 (S), R14.1, R15.1, R16.1, S2.1, U$3.4 (GND), U$6.GND, U$7.GND, U$8.GND, U$9.P$3, U$9.P$4, U$10.GND, U$11.GND, U$12.GND; also elsewhere on the board
LEDS: R5.1; also elsewhere on the board
LIGHT: JP15.4; also elsewhere on the board
LS1: IC1.6 (O); also elsewhere on the board
LS2: IC1.8 (O); also elsewhere on the board
LS3: IC1.4 (O); also elsewhere on the board
LS4: IC1.10 (O); also elsewhere on the board
LS5: IC1.2 (O); also elsewhere on the board
LS6: IC1.12 (O); also elsewhere on the board
MISO: JP20.P$1 (1); also elsewhere on the board
MOSI: JP20.P$4 (4); also elsewhere on the board
N1: C6.+, IC1.5 (I), R8.2
N2: C7.+, IC1.9 (I), R9.2
N3: C11.+, IC1.3 (I), R10.2
N5: C13.+, IC1.1 (I), R12.2
N6: C14.+, IC1.13 (I), R13.2
unnamed: C12.+, IC1.11 (I), R11.2
unnamed: JP10.1, R10.1
unnamed: JP11.1, R11.1
unnamed: JP12.1, R12.1
unnamed: U$6.DOUT, U$7.DIN
unnamed: U$8.DOUT, U$10.DIN
unnamed: R5.2, U$6.DIN
unnamed: U$7.DOUT, U$8.DIN
unnamed: J1.1 (-), Q1.3 (D)
unnamed: JP8.P$2 (2), R8.1
unnamed: JP8.P$1 (1), R9.1
unnamed: JP9.1, R13.1
unnamed: U$10.DOUT, U$11.DIN
unnamed: J3.SLEEVE, U$12.SPK-
unnamed: J3.RING, U$12.SPK+
unnamed: D1.C, R15.2
unnamed: D2.C, R16.2
PIR: JP1.1; also elsewhere on the board
POT1: JP7.3; also elsewhere on the board
POT2: JP5.3; also elsewhere on the board
POT3: JP6.3; also elsewhere on the board
POT4: JP13.3; also elsewhere on the board
SCK: JP20.P$3 (3); also elsewhere on the board
SERVO: JP2.1; also elsewhere on the board
SS: JP20.P$5 (5); also elsewhere on the board
SW1: JP19.2, R7.2; also elsewhere on the board
SW2: R6.2, S2.3 (2); also elsewhere on the board
S_BUSY: U$12.BUSY; also elsewhere on the board
S_DCLK: U$12.DCLK; also elsewhere on the board
S_DIN: U$12.DIN; also elsewhere on the board
S_RESET: U$12.RESET; also elsewhere on the board
TEMPSENSE: C8.1, U$3.1 (VOUT); also elsewhere on the board
VBAT: BAT1.1 (+); also elsewhere on the board
VTG: JP20.P$2 (2); also elsewhere on the board

Notes on the sheet:
5V Conversion Circuit
Cooling Fan (x2) Driver Circuit
Temp Sensor Circuit
PIR Circuit
Servo Circuit
Pot 1, 2, 3 Circuit
Power/Status LED Circuit
MP3 Circuit
Limit Switch Buttons
Interface Buttons
Coin Cell Battery Circuit
3.3V Conversion Circuit
Light Control
Vulture Board Assorted Peripherals
Drawn by: Ward Prescott - CPE Bucknell '17 Email: erp006@bucknell.edu
Wing Tips
Wings
Neck
Adfruit NeoPixels
Power
Unused Breakout

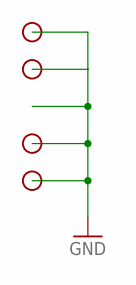
[picture p35: schematic Vulture Controls - Copy.sch, sheet 5, Holes and Misc.]

Parts:
STANDOFF1, STANDOFF2, STANDOFF4, STANDOFF6: STAND-OFF

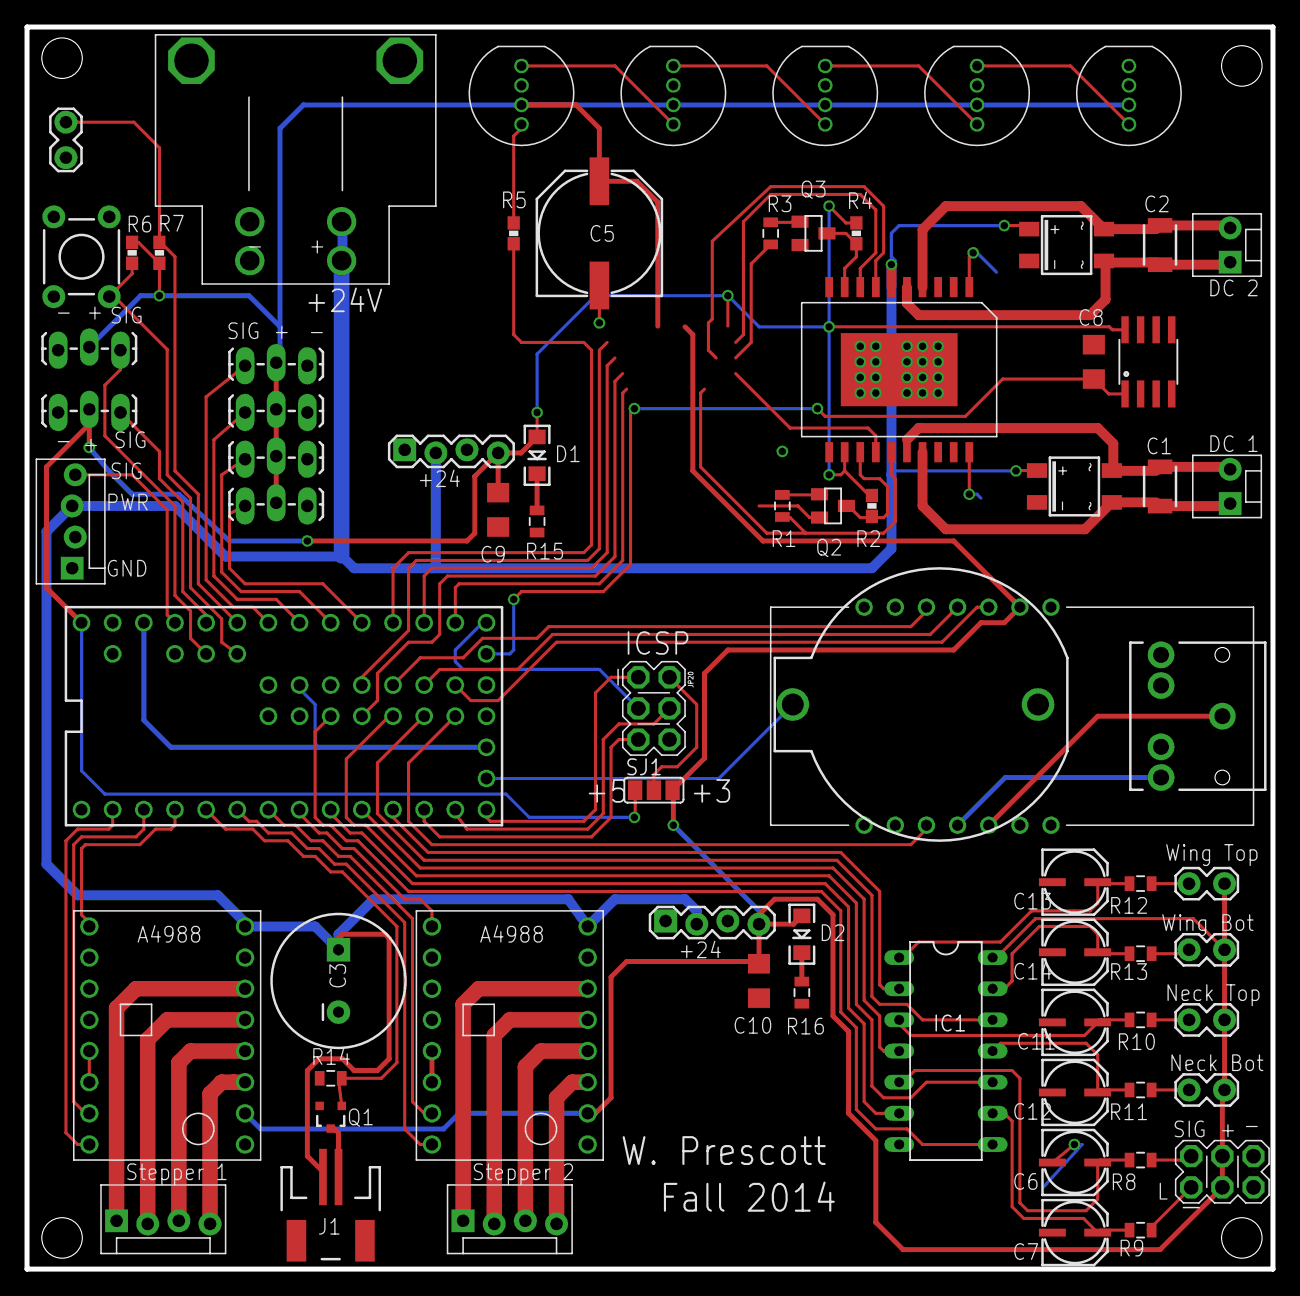
[picture p36: board Vulture Controls - Copy.brd from above]

Board: 2 copper layers, 101.6 x 101.3 mm, 78 parts (0 on the bottom side), 83 nets.
