kitekid250/The-Vulture/(commit log)

2015-04-28 Bulk Commit
    All the files. I'll work through this later.
    [Arcs and Moments.xlsx, Base Disk 2.SLDPRT, Base Disk.SLDPRT, Base Frame Assembly v1.SLDASM, Base Frame Assembly vF Left.SLDASM, Beak Right.sldprt, Beak left.sldprt, Block Support v0.SLDPRT]
2015-05-03 Added Neck Homing
    Using a more simple procedure than I'd hoped, the neck can now home
    itself on the final motion. Other homing mechanisms to come.
2015-05-15 Cleaned Up Directory
    Added a few mechanical parts too.
    [Arcs and Moments.xlsx, ArmsPotentiometerSupport_Revised.SLDPRT, ArmsPotentiometerSupport_Revised.STL, Back plate.SLDPRT, Bar.SLDPRT, Base Disk 2.SLDPRT, Base Disk.SLDPRT, Base Frame Assembly v1.SLDASM]
2015-05-24 Added Front Panel 2Ds
    [Front Panel.SLDDRW, Front Panel.SLDPRT]
2015-05-24 Reduced LED Brightness
2015-05-25 Tweaked 3rd Motion Timing, Commented out Wings
2015-09-29 Vulture Rollout V2
    Fixed the original problem with the wings which required a bit of code
    updating.
    [Vulture Controls - Copy.brd, Vulture Controls - Copy.sch]
